ronisillman/FilaBoss/README.md

# FilaBoss
Mechatronics Project Filament Maker
