ronisillman/FilaBoss/PCB/FilaBoss_control_PCB/Print Schematic.pdf

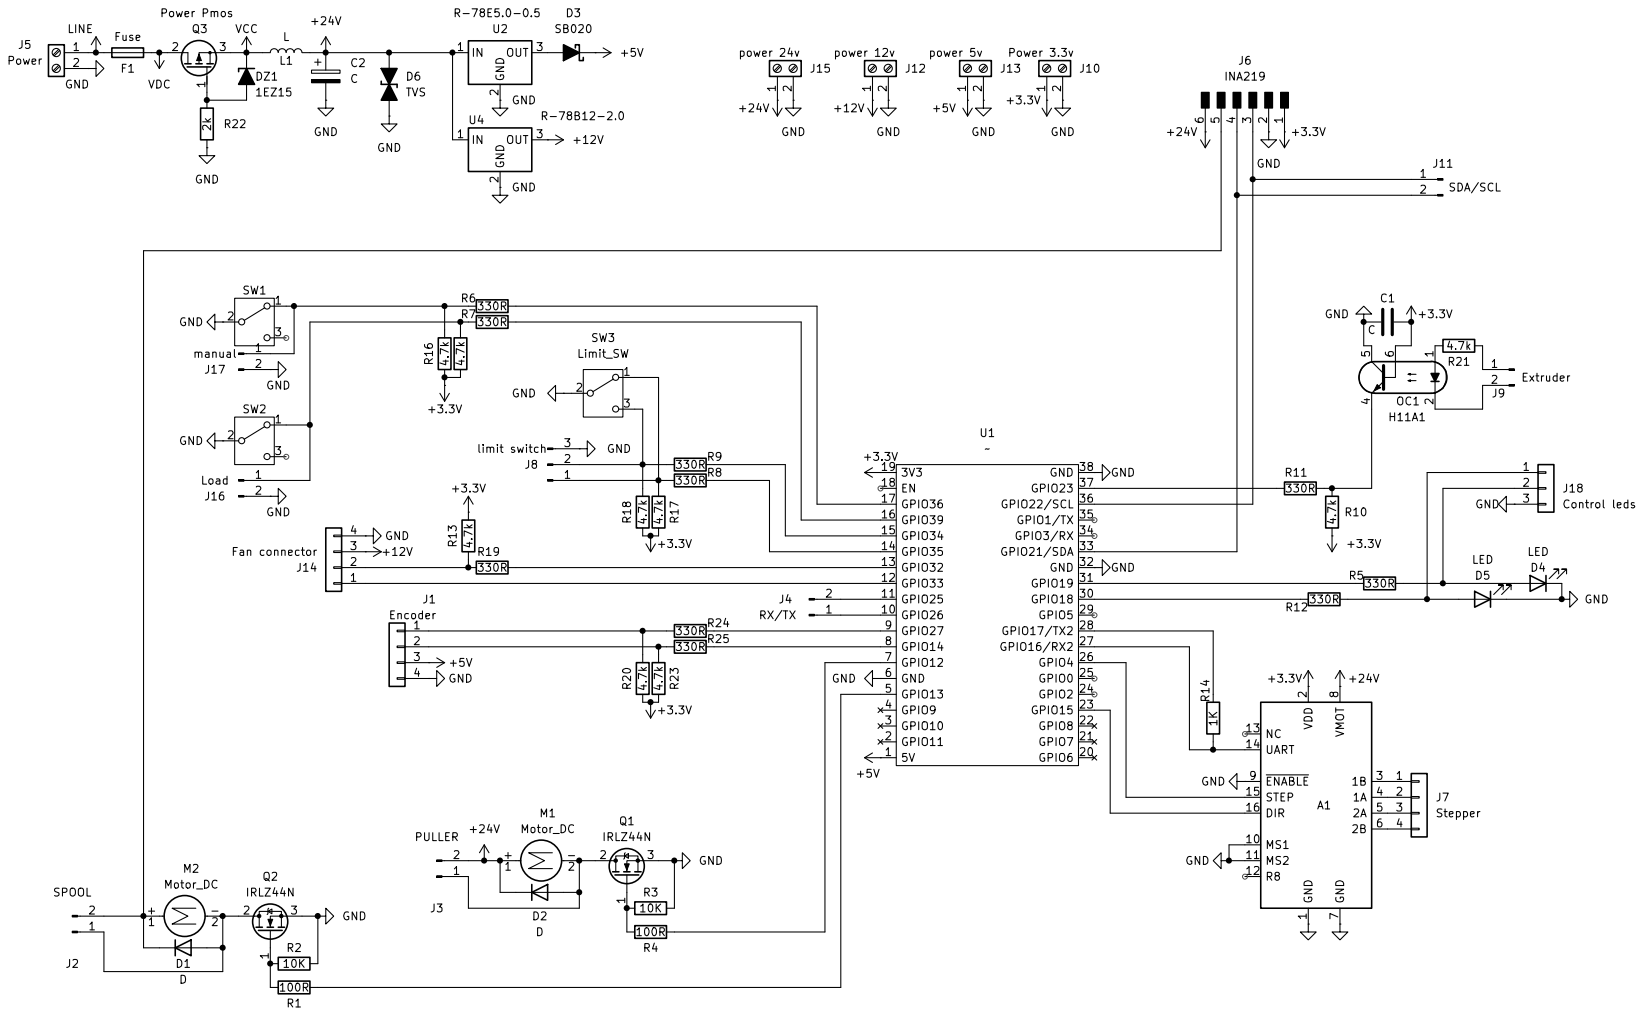
[picture p1: page 1]
