ronisillman/FilaBoss/PCB/FilaBoss_control_PCB/board.pdf

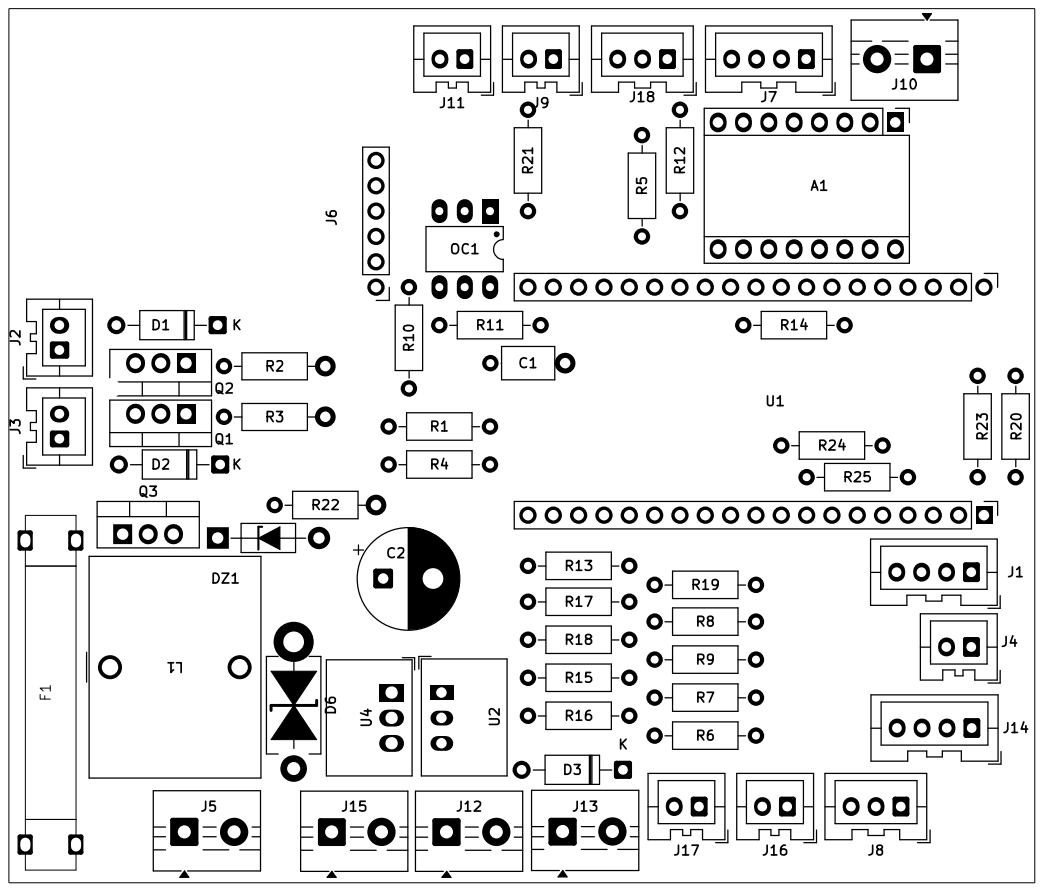
[picture p2: page 1]
