ronisillman/FilaBoss/PCB/FilaBoss_control_PCB/FilaBoss_control_PCB.kicad_pcb

## KiCad design PCB/FilaBoss_control_PCB/FilaBoss_control_PCB.kicad_pcb (2026-04-21)

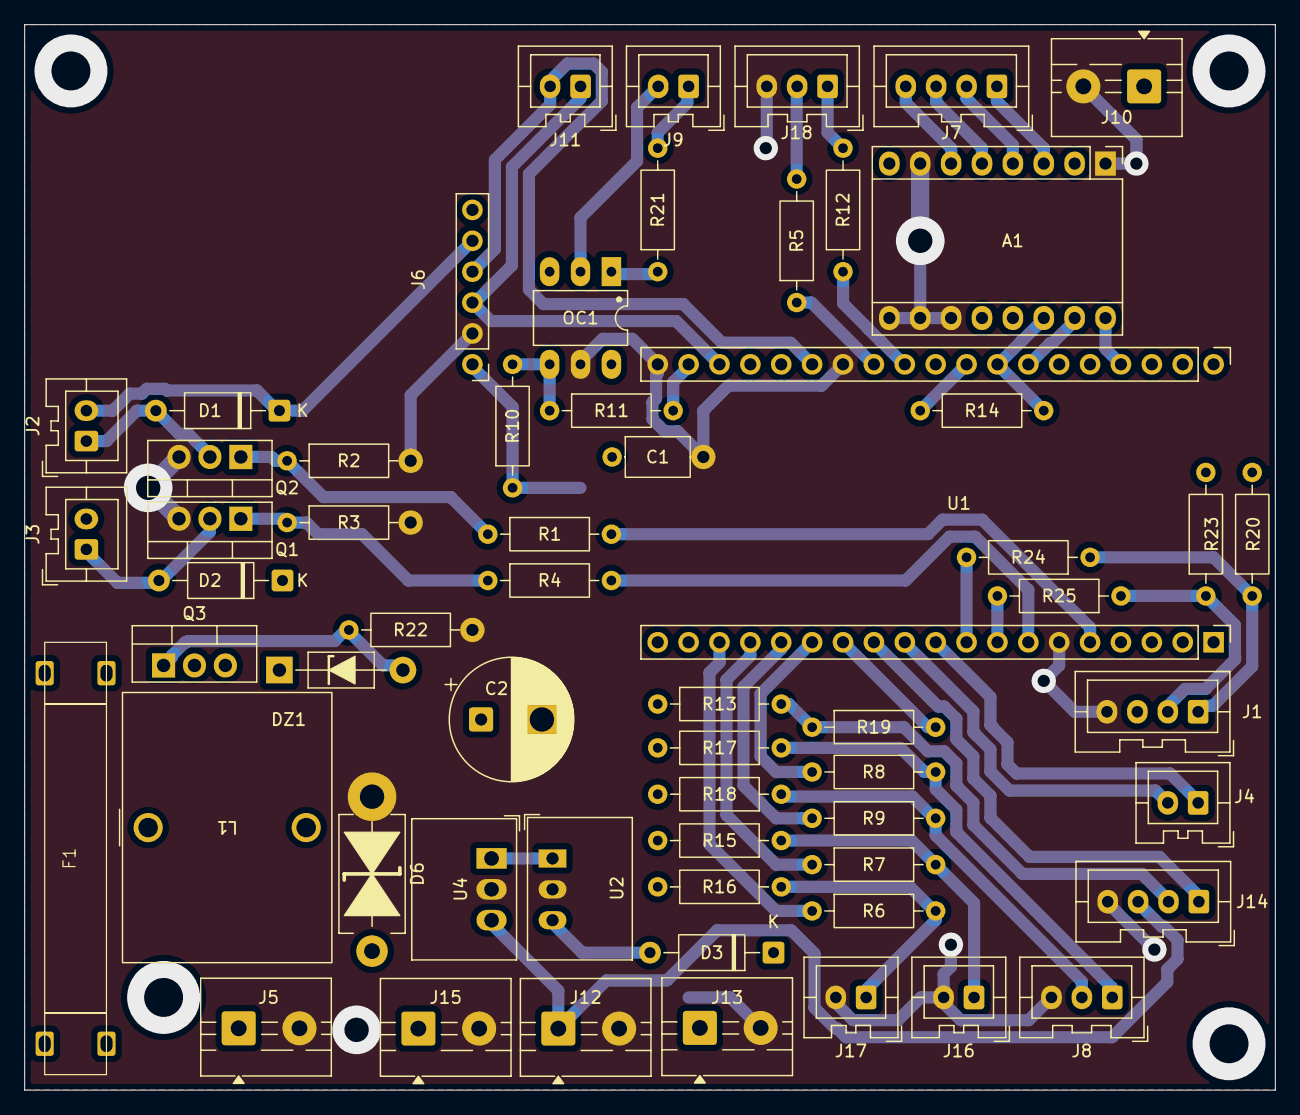
[picture p3: board FilaBoss_control_PCB.kicad_pcb from above]

Board: 2 copper layers, 102.9 x 87.6 mm, 60 parts (0 on the bottom side), 53 nets.

Parts:
A1: Pololu_Breakout_A4988; Pololu_Breakout-16_15.2x20.3mm
C1: C; C_Axial_L5.1mm_D3.1mm_P7.50mm_Horizontal
C2: C; CP_Radial_D10.0mm_P5.00mm
D1, D2: D; D_A-405_P10.16mm_Horizontal
D3: SB020; D_A-405_P10.16mm_Horizontal
D6: TVS; D_DO-201_P12.70mm_Horizontal_TVS
DZ1: 1EZ15; D_DO-41_SOD81_P10.16mm_Horizontal_Zener
F1: Fuse; fuse
J1: Encoder; JST_XA_B04B-XASK-1_1x04_P2.50mm_Vertical
J2: SPOOL; JST_XA_B02B-XASK-1_1x02_P2.50mm_Vertical
J3: PULLER; JST_XA_B02B-XASK-1_1x02_P2.50mm_Vertical
J4: RX/TX; JST_XA_B02B-XASK-1_1x02_P2.50mm_Vertical
J5: Power; TerminalBlock_MaiXu_MX126-5.0-02P_1x02_P5.00mm
J6: INA219; PinHeader_01x06_P2.54mm_Vertical_THT_D1mm
J7: Stepper; JST_XA_B04B-XASK-1_1x04_P2.50mm_Vertical
J8: limit switch; JST_XA_B03B-XASK-1_1x03_P2.50mm_Vertical
J9: Extruder; JST_XA_B02B-XASK-1_1x02_P2.50mm_Vertical
J10: Power 3.3v; TerminalBlock_MaiXu_MX126-5.0-02P_1x02_P5.00mm
J11: SDA/SCL; JST_XA_B02B-XASK-1_1x02_P2.50mm_Vertical
J12: power 12v; TerminalBlock_MaiXu_MX126-5.0-02P_1x02_P5.00mm
J13: power 5v; TerminalBlock_MaiXu_MX126-5.0-02P_1x02_P5.00mm
J14: Fan connector; JST_XA_B04B-XASK-1_1x04_P2.50mm_Vertical
J15: power 24v; TerminalBlock_MaiXu_MX126-5.0-02P_1x02_P5.00mm
J16: Load; JST_XA_B02B-XASK-1_1x02_P2.50mm_Vertical
J17: manual; JST_XA_B02B-XASK-1_1x02_P2.50mm_Vertical
J18: Control leds; JST_XA_B03B-XASK-1_1x03_P2.50mm_Vertical
L1: L; L_Wurth_WE-HCFT-2012_LeadDiameter1.2mm
OC1: H11A1; DIP-6_W7.62mm_LongPads
Q1, Q2: IRLZ44N; TO-220-3_Vertical
Q3: IRF9540N; TO-220-3_Vertical_GDS
R1, R4: 100R; R_Axial_DIN0207_L6.3mm_D2.5mm_P10.16mm_Horizontal
R2, R3: 10K; R_Axial_DIN0207_L6.3mm_D2.5mm_P10.16mm_Horizontal
R5, R6, R7, R8, R9, R11, R12, R19, R24, R25: 330R; R_Axial_DIN0207_L6.3mm_D2.5mm_P10.16mm_Horizontal
R10, R13, R15, R16, R17, R18, R20, R21, R23: 4.7k; R_Axial_DIN0207_L6.3mm_D2.5mm_P10.16mm_Horizontal
R14: 1K; R_Axial_DIN0207_L6.3mm_D2.5mm_P10.16mm_Horizontal
R22: 2k; R_Axial_DIN0207_L6.3mm_D2.5mm_P10.16mm_Horizontal
U1: ESP32 Wroom dev-kit
U2: R-78E5.0-0.5; Converter_DCDC_RECOM_R-78E-0.5_THT
U4: R-78B12-2.0; Converter_DCDC_RECOM_R-78B-2.0_THT

Connections:
+3.3V: A1.2 (VDD), C1.1, J6.1, J10.1, OC1.6, R10.1, R13.1, R15.2, R16.2, R17.2, R18.2, R20.2, R23.2, U1.19 (3V3)
+5V: D3.1 (K), J1.3, J13.1, U1.1 (5V)
+12V: J12.1, J14.3, U4.3 (OUT)
+24V: A1.8 (VMOT), C2.1, D2.1 (K), D6.2 (A), J3.2, J6.6, J15.1, L1.2, U2.1 (IN), U4.1 (IN)
GND: A1.1 (GND), A1.7 (GND), A1.9 (~ENABLE), A1.10 (MS1), A1.11 (MS2), C1.2, C2.2, D6.1 (K), J1.4, J5.2, J6.2, J8.3, J10.2, J12.2, J13.2, J14.4, J15.2, J16.2, J17.2, J18.3, OC1.5, Q1.3 (S), Q2.3 (S), R2.2, R3.2, R22.1, U1.6 (GND), U1.32 (GND), U1.38 (GND), U2.2 (GND), U4.2 (GND)
LINE: F1.1, J5.1
unnamed: A1.4 (1A), J7.2
unnamed: A1.3 (1B), J7.1
unnamed: A1.5 (2A), J7.3
unnamed: A1.6 (2B), J7.4
unnamed: A1.16 (DIR), U1.23 (GPIO15)
unnamed: A1.15 (STEP), U1.26 (GPIO4)
unnamed: A1.14 (UART), R14.2, U1.27 (GPIO16/RX2)
unnamed: D1.2 (A), J2.1, Q2.2 (D)
unnamed: D1.1 (K), J2.2, J6.5
unnamed: D2.2 (A), J3.1, Q1.2 (D)
unnamed: D3.2 (A), U2.3 (OUT)
unnamed: DZ1.2 (A), Q3.1 (G), R22.2
unnamed: J1.1, R20.1, R24.1
unnamed: J1.2, R23.1, R25.1
unnamed: J4.1, U1.10 (GPIO26)
unnamed: J4.2, U1.11 (GPIO25)
unnamed: J8.1, R8.1, R17.1
unnamed: J8.2, R9.1, R18.1
unnamed: J9.1, R21.2
unnamed: J9.2, OC1.2
unnamed: J6.3, J11.1, U1.36 (GPIO22/SCL)
unnamed: J6.4, J11.2, U1.33 (GPIO21/SDA)
unnamed: J14.1, U1.12 (GPIO33)
unnamed: J14.2, R13.2, R19.1
unnamed: J16.1, R7.2, R15.1
unnamed: J17.1, R6.2, R16.1
unnamed: J18.1, R12.2
unnamed: J18.2, R5.2
unnamed: OC1.1, R21.1
unnamed: OC1.4, R10.2, R11.1
unnamed: Q1.1 (G), R3.1, R4.1
unnamed: Q2.1 (G), R1.1, R2.1
unnamed: R4.2, U1.7 (GPIO12)
unnamed: R1.2, U1.5 (GPIO13)
unnamed: R25.2, U1.8 (GPIO14)
unnamed: R14.1, U1.28 (GPIO17/TX2)
unnamed: R12.1, U1.30 (GPIO18)
unnamed: R5.1, U1.31 (GPIO19)
unnamed: R11.2, U1.37 (GPIO23)
unnamed: R24.2, U1.9 (GPIO27)
unnamed: R19.2, U1.13 (GPIO32)
unnamed: R9.2, U1.15 (GPIO34)
unnamed: R8.2, U1.14 (GPIO35)
unnamed: R6.1, U1.17 (GPIO36)
unnamed: R7.1, U1.16 (GPIO39)
VCC: DZ1.1 (K), L1.1, Q3.3 (S)
VDC: F1.2, Q3.2 (D)
