ronisillman/FilaBoss/PCB/FilaBoss_control_PCB/FilaBoss_control_PCB_s.kicad_pcb

## KiCad design PCB/FilaBoss_control_PCB/FilaBoss_control_PCB_s.kicad_pcb (2026-03-24)

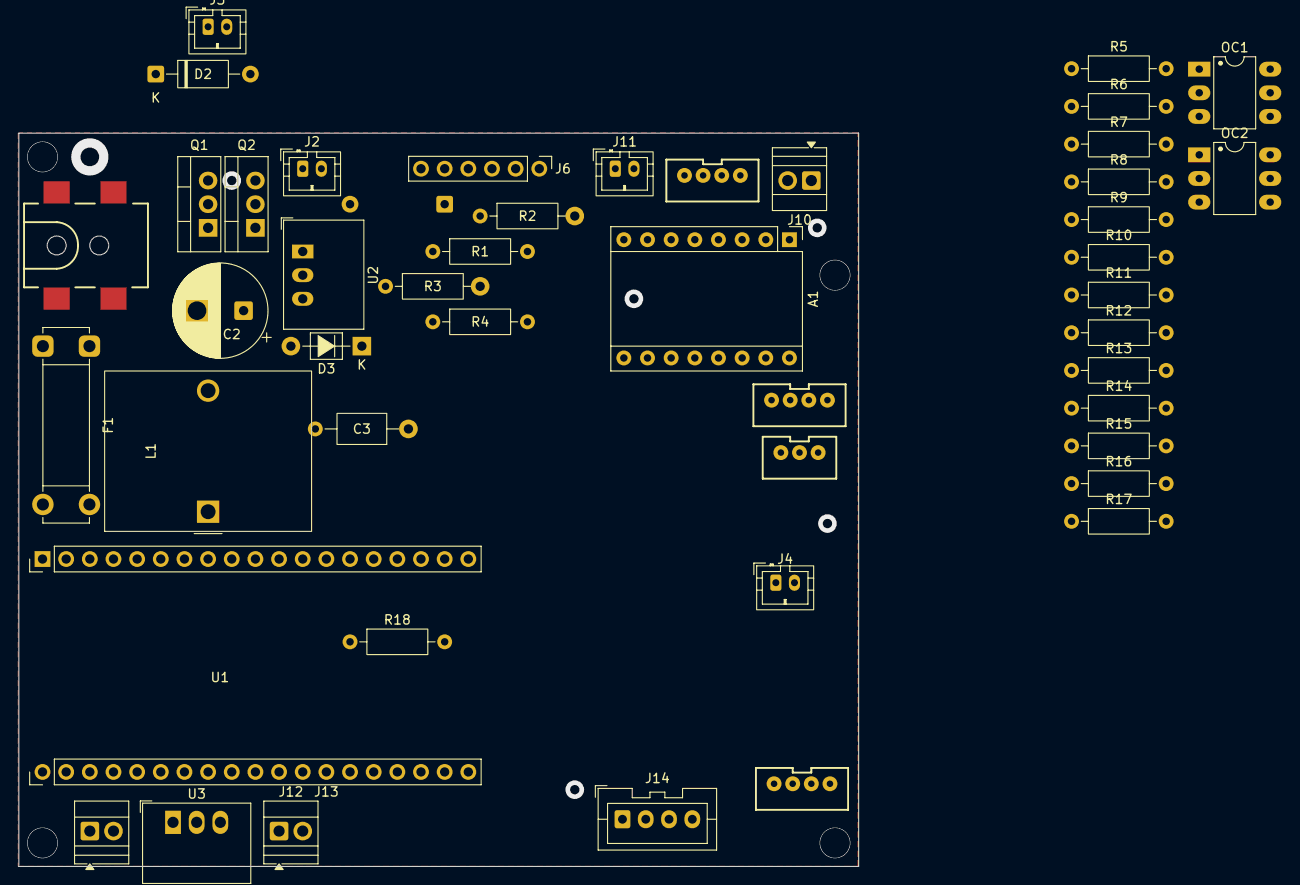
[picture p4: board FilaBoss_control_PCB_s.kicad_pcb from above]

Board: 2 copper layers, 90.2 x 78.7 mm, 47 parts (1 on the bottom side), 45 nets, no tracks yet.

Parts:
A1: Pololu_Breakout_A4988; Pololu_Breakout-16_15.2x20.3mm
C2: C; CP_Radial_D10.0mm_P5.00mm
C3: C; C_Axial_L5.1mm_D3.1mm_P10.00mm_Horizontal
D1, D2: D; D_A-405_P10.16mm_Horizontal
D3: SB020; D_T-1_P7.62mm_Horizontal
F1: Fuse; Fuseholder_Clip-5x20mm_Littelfuse_521_Lateral_P17.00x5.00mm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
J1: Encoder; JST_1x04_P2.0mm_Vertical_PTH
J2: SPOOL; JST_PH_B2B-PH-K_1x02_P2.00mm_Vertical
J3: PULLER; JST_PH_B2B-PH-K_1x02_P2.00mm_Vertical
J4: RX/TX; JST_PH_B2B-PH-K_1x02_P2.00mm_Vertical
J5: Barrel_Jack_SMD
J6: INA219; PinHeader_01x06_P2.54mm_Vertical_THT_D1mm
J7: Stepper; JST_1x04_P2.0mm_Vertical_PTH
J8: limit switch; JST_1x03_P2.0mm_Vertical_PTH
J9: Conn_01x04_Pot; JST_1x04_P2.0mm_Vertical_PTH
J10: Power 3.3v; TerminalBlock_Xinya_XY308-2.54-2P_1x02_P2.54mm_Horizontal
J11: SCL/SDA; JST_PH_B2B-PH-K_1x02_P2.00mm_Vertical
J12: power 12v; TerminalBlock_Xinya_XY308-2.54-2P_1x02_P2.54mm_Horizontal
J13: power 5v; TerminalBlock_Xinya_XY308-2.54-2P_1x02_P2.54mm_Horizontal
J14: Fan connector; JST_XA_B04B-XASK-1_1x04_P2.50mm_Vertical
L1: L; L_Wurth_WE-HCFT-2012_LeadDiameter1.2mm
OC1, OC2: H11A1; DIP-6_W7.62mm_LongPads
Q1, Q2: IRLZ44N; TO-220-3_Vertical
R1, R4, R5, R6, R7, R8, R9: 100R; R_Axial_DIN0207_L6.3mm_D2.5mm_P10.16mm_Horizontal
R2, R3: 10K; R_Axial_DIN0207_L6.3mm_D2.5mm_P10.16mm_Horizontal
R10, R11: 330R; R_Axial_DIN0207_L6.3mm_D2.5mm_P10.16mm_Horizontal
R12, R13, R14, R15, R16, R17, R18: 4.7k; R_Axial_DIN0207_L6.3mm_D2.5mm_P10.16mm_Horizontal
U1: ESP32 Wroom dev-kit
U2: R-78E5.0-0.5; Converter_DCDC_RECOM_R-78E-0.5_THT
U3: R-78B12-2.0; Converter_DCDC_RECOM_R-78B-2.0_THT

Connections:
+3.3V: A1.2 (VDD), A1.10 (MS1), A1.11 (MS2), A1.12 (MS3), A1.13 (~RESET), A1.14 (~SLEEP), J6.1, J10.2, R12.2, R13.2, R14.2, R15.2, R16.2, R17.2, R18.2, U1.19 (3V3)
+5V: C3.2, D3.1 (K), J1.2, J13.1, R10.2, R11.2, U1.1 (5V)
+12V: J12.1, J14.2, U3.3 (OUT)
+24V: A1.8 (VMOT), C2.1, D2.1 (K), J3.2 (+), J6.6, L1.2, U2.1 (IN), U3.1 (IN)
GND: A1.1 (GND), A1.7 (GND), A1.9 (~ENABLE), C2.2, C3.1, J1.1, J5.GND, J6.2, J8.3, J9.1, J10.1, J12.2, J13.2, J14.1, OC1.5, OC2.5, Q1.3 (S), Q2.3 (S), R2.2, R3.2, U1.6 (GND), U1.32 (GND), U1.38 (GND), U2.2 (GND), U3.2 (GND)
LINE: F1.1, J5.PWR
unnamed: A1.4 (1A), J7.2
unnamed: A1.3 (1B), J7.1
unnamed: A1.5 (2A), J7.3
unnamed: A1.6 (2B), J7.4
unnamed: A1.16 (DIR), U1.13 (GPIO32)
unnamed: A1.15 (STEP), U1.12 (GPIO33)
unnamed: D1.2 (A), J2.1 (-), Q2.2 (D)
unnamed: D1.1 (K), J2.2 (+), J6.5
unnamed: D2.2 (A), J3.1 (-), Q1.2 (D)
unnamed: D3.2 (A), U2.3 (OUT)
unnamed: J1.3, OC2.2
unnamed: J1.4, OC1.2
unnamed: J4.2 (+), U1.28 (GPIO17/TX2)
unnamed: J4.1 (-), U1.27 (GPIO16/RX2)
unnamed: J8.1, R9.1, R18.1
unnamed: J8.2, R8.1, R17.1
unnamed: J9.2, R5.2, R14.1
unnamed: J9.3, R7.2, R15.1
unnamed: J9.4, R6.2, R16.1
unnamed: J6.4, J11.2 (+), U1.33 (GPIO21/SDA)
unnamed: J6.3, J11.1 (-), U1.36 (GPIO22/SCL)
unnamed: J14.3, U1.25 (GPIO0)
unnamed: J14.4, U1.24 (GPIO2)
unnamed: OC1.1, R10.1
unnamed: OC1.6, R12.1
unnamed: OC2.1, R11.1
unnamed: OC2.6, R13.1
unnamed: Q1.1 (G), R3.1, R4.1
unnamed: Q2.1 (G), R1.1, R2.1
unnamed: R5.1, U1.29 (GPIO5)
unnamed: R9.2, U1.7 (GPIO12)
unnamed: R8.2, U1.5 (GPIO13)
unnamed: OC1.4, U1.8 (GPIO14)
unnamed: R7.1, U1.30 (GPIO18)
unnamed: R6.1, U1.31 (GPIO19)
unnamed: R1.2, U1.11 (GPIO25)
unnamed: R4.2, U1.10 (GPIO26)
unnamed: OC2.4, U1.9 (GPIO27)
VDC: F1.2, L1.1
