ronisillman/FilaBoss/PCB/FilaBoss_control_PCB/FilaBoss_control_PCB_b.kicad_pcb

## KiCad design PCB/FilaBoss_control_PCB/FilaBoss_control_PCB_b.kicad_pcb (2026-03-13)

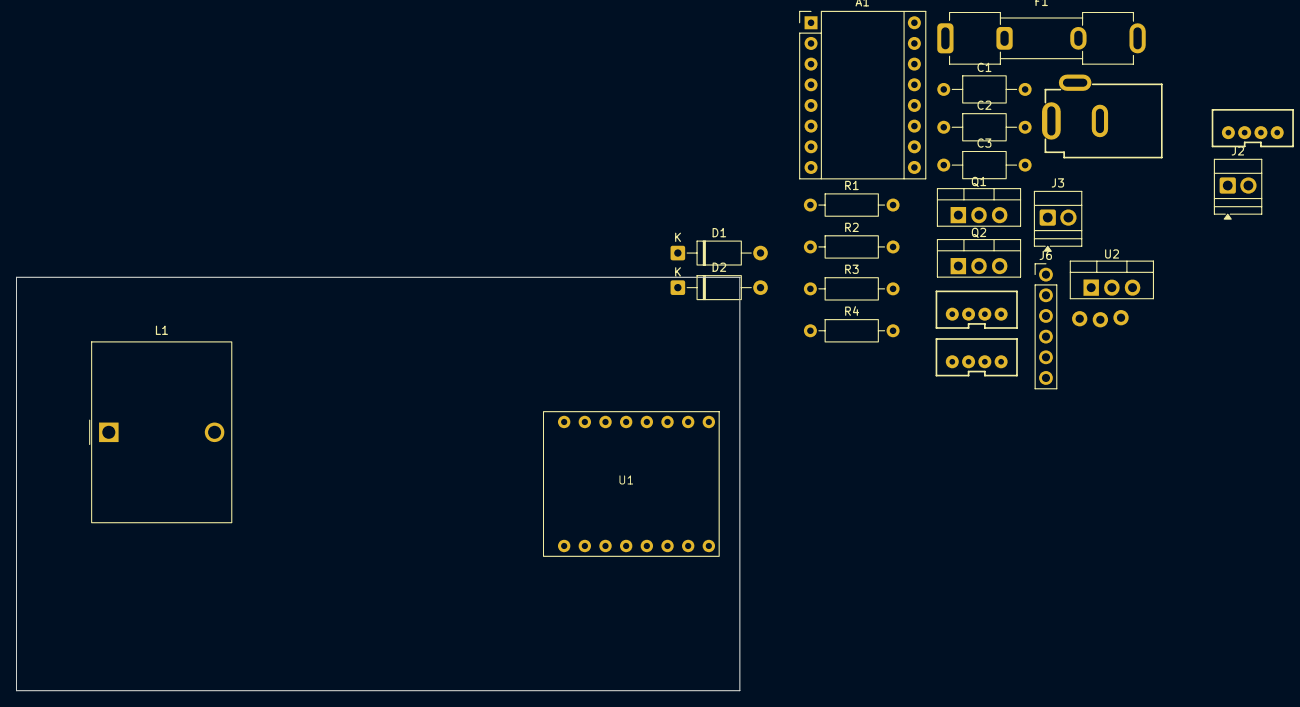
[picture p5: board FilaBoss_control_PCB_b.kicad_pcb from above]

Board: 2 copper layers, 88.9 x 50.8 mm, 24 parts (0 on the bottom side), 29 nets, no tracks yet.

Parts:
A1: Pololu_Breakout_A4988; Pololu_Breakout-16_15.2x20.3mm
C1, C2, C3: C; C_Axial_L5.1mm_D3.1mm_P10.00mm_Horizontal
D1, D2: D; D_A-405_P10.16mm_Horizontal
F1: Fuse; Fuseholder_Clip-5x20mm_Keystone_3512P_Inline_P23.62x7.27mm_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
J1, J9: Conn_01x04_Encoder; JST_1x04_P2.0mm_Vertical_PTH
J2, J3: Screw_Terminal_01x02; TerminalBlock_Xinya_XY308-2.54-2P_1x02_P2.54mm_Horizontal
J5: Barrel_Jack_PTH_Slot
J6: PinHeader_01x06_P2.54mm_Vertical_THT_D1mm
J7: Conn_01x04; JST_1x04_P2.0mm_Vertical_PTH
J8: Conn_01x03; 1x03_P2.54mm_Locking
L1: L; L_Wurth_WE-HCFT-2012_LeadDiameter1.2mm
Q1, Q2: IRLZ44N; TO-220-3_Vertical
R1, R4: 100R; R_Axial_DIN0207_L6.3mm_D2.5mm_P10.16mm_Horizontal
R2, R3: 10K; R_Axial_DIN0207_L6.3mm_D2.5mm_P10.16mm_Horizontal
U1: ESP32_C3_super_mini; ESP32-super-mini
U2: LM78M05_TO220; TO-220-3_Vertical

Connections:
+24V: F1.1, J5.PWR
GND: A1.1 (GND), A1.7 (GND), A1.9 (~ENABLE), C1.2, C2.2, C3.2, J1.4, J5.GND, J6.2, J8.3, J9.1, Q1.3 (S), Q2.3 (S), R2.2, R3.2, U1.12 (GND), U2.2 (GND)
unnamed: A1.4 (1A), J7.2
unnamed: A1.3 (1B), J7.1
unnamed: A1.5 (2A), J7.3
unnamed: A1.6 (2B), J7.4
unnamed: A1.16 (DIR), U1.20 (D7/RX)
unnamed: A1.2 (VDD), A1.10 (MS1), A1.11 (MS2), A1.12 (MS3), J1.3, J6.1, U1.11 (3V3)
unnamed: A1.15 (STEP), U1.21 (D6/TX)
unnamed: A1.8 (VMOT), C2.1, D1.1 (K), D2.1 (K), J2.1, J3.1, L1.2, U2.1 (VI)
unnamed: A1.13 (~RESET), A1.14 (~SLEEP)
unnamed: D1.2 (A), J2.2, J6.6
unnamed: D2.2 (A), J3.2, Q1.2 (D)
unnamed: F1.2, L1.1
unnamed: J1.1, U1.4 (D2/A2)
unnamed: J1.2, U1.3 (D1/A1)
unnamed: J6.3, U1.7 (D5/SCL)
unnamed: J6.4, U1.6 (D4/SDA)
unnamed: J6.5, Q2.2 (D)
unnamed: J8.1, U1.1 (ADC1-1)
unnamed: J8.2, U1.0 (ADC1-0)
unnamed: J9.2, U1.10 (D10/MOSI)
unnamed: J9.3, U1.9 (D9/MISO)
unnamed: J9.4, U1.8 (D8/SCK)
unnamed: Q1.1 (G), R3.1, R4.1
unnamed: Q2.1 (G), R1.1, R2.1
unnamed: C1.1, C3.1, U1.13 (5V), U2.3 (VO)
unnamed: R4.2, U1.2 (D0/A0)
unnamed: R1.2, U1.5 (D3/A3)
