ronisillman/FilaBoss/Arduino code/Control/Winding_line_control_esp/pid.h

// PID Controller Class for Arduino

class PID {
private:
  float kp, ki, kd;
  float setpoint;
  float integral;
  float previousError;
  unsigned long lastTime;
  float outputMin, outputMax, output;
  float derivativeFilterCoeff;  // Filter coefficient for derivative smoothing (0.1-1.0)
  float previousFilteredDerivative;  // Previous filtered derivative value

public:
  // Constructor
  PID(float kp_val = 0.0, float ki_val = 0.0, float kd_val = 0.0) {
    kp = kp_val;
    ki = ki_val;
    kd = kd_val;
    setpoint = 0.0;
    integral = 0.0;
    previousError = 0.0;
    lastTime = micros();
    outputMin = -255.0;
    outputMax = 255.0;
    output = 0.0;
    derivativeFilterCoeff = 0.2;  // Default filter coefficient (lower = more smoothing)
    previousFilteredDerivative = 0.0;
  }

  // Set PID tuning parameters
  void setTunings(float kp_val, float ki_val, float kd_val) {
    kp = kp_val;
    ki = ki_val;
    kd = kd_val;
    previousFilteredDerivative = 0.0; // Reset filter state: old state was scaled by previous kd
  }

  // Get PID tuning parameters
  float getKp() { return kp; }
  float getKi() { return ki; }
  float getKd() { return kd; }

  // Set derivative filter coefficient (0.0-1.0, lower = more smoothing)
  void setDerivativeFilter(float filterCoeff) {
    derivativeFilterCoeff = constrain(filterCoeff, 0.01, 1.0);
  }

  // Set the desired setpoint
  void setSetpoint(float target) {
    setpoint = target;
  }

  // Set output limits
  void setOutputLimits(float minOut, float maxOut) {
    outputMin = minOut;
    outputMax = maxOut;
  }

  float compute(float feedback, float feedforwardInput = 0.0f) {
    unsigned long currentTime = micros();
    float deltaTime = (currentTime - lastTime) / 1000000.0; // Convert to seconds

    // Avoid division by zero - return previous output if no time has passed
    if (deltaTime == 0) return output;
    
    lastTime = currentTime;

    // Calculate error
    float error = setpoint - feedback;

    // Proportional term
    float proportional = kp * error;

    // Derivative term with filtering
    float rawDerivative = kd * (error - previousError) / deltaTime;
    float derivative = previousFilteredDerivative + derivativeFilterCoeff * (rawDerivative - previousFilteredDerivative);
    previousFilteredDerivative = derivative;

    // Integral term with anti-windup: only update if the new output would not drive further into saturation
    float deltaIntegral = ki * error * deltaTime;
    float prospectiveIntegral = integral + deltaIntegral;
    float prospectiveOutput = proportional + prospectiveIntegral + derivative + feedforwardInput;
    if (!((prospectiveOutput > outputMax && deltaIntegral > 0.0f) ||
          (prospectiveOutput < outputMin && deltaIntegral < 0.0f))) {
      integral = prospectiveIntegral;
    }

    // Store error for next iteration
    previousError = error;

    // Calculate output with feedforward
    output = proportional + integral + derivative + feedforwardInput;

    // Limit output
    output = constrain(output, outputMin, outputMax);
    return output;
  }

  // Reset the controller
  void reset() {
    integral = 0.0;
    previousError = 0.0;
    previousFilteredDerivative = 0.0;
    lastTime = micros();
  }

  // Get current setpoint
  float getSetpoint() {
    return setpoint;
  }

  // Get current integral value
  float getIntegral() {
    return integral;
  }

  // Get current output value
  float getOutput() {
    return output;
  }

  // Get current output limits
  float getOutputMax() {
    return outputMax;
  }
  float getOutputMin() {
    return outputMin;
  }

  // Get derivative filter coefficient
  float getDerivativeFilter() {
    return derivativeFilterCoeff;
  }
};
