ronisillman/FilaBoss/Arduino code/DC_motor_encoder_pulses/DC_motor_encoder_pulses.ino

#define encoderPin 2

volatile long pulseCount = 0;
volatile bool lastState = LOW;

void setup() {
  pinMode(encoderPin, INPUT);
  Serial.begin(9600);

  attachInterrupt(digitalPinToInterrupt(encoderPin), countPulse, CHANGE);
}

void loop() {
  static unsigned long lastTime = 0;
  if (millis() - lastTime >= 1000) {
    noInterrupts();
    long pulses = pulseCount;
    pulseCount = 0;
    interrupts();

    Serial.print("Pulses in last 1 s: ");
    Serial.println(pulses);
    lastTime = millis();
  }
}

void countPulse() {
  static unsigned long lastBounceTime = 0;
  unsigned long now = micros();  // micros() for better debounce resolution
  
  // Debounce with 1000µs (1ms) threshold
  if (now - lastBounceTime > 1000) {
    bool state = digitalRead(encoderPin);
    if (state == HIGH && lastState == LOW) {
      pulseCount++;
    }
    lastState = state;
    lastBounceTime = now;
  }
}
