ronisillman/FilaBoss/python_lcd_ui/main.py

from __future__ import annotations

# pyright: reportMissingImports=false

import argparse
import csv
import importlib
import json
import math
import os
import socket
import time
from dataclasses import asdict, dataclass
from typing import Any

from display_hardware import HardwareLcdDisplay
from display_simulator import SimulatedLcdDisplay
from input_devices import InputEvent, RotaryButtonInput
from ui_controller import UiController


DEFAULT_UNIX_SOCKET_PATH = os.path.join(
    os.path.dirname(os.path.abspath(__file__)),
    "sockets",
    "filament_socket.sock",
)
UI_STATE_PATH = os.path.join(
    os.path.dirname(os.path.abspath(__file__)),
    "ui_state.json",
)


@dataclass
class TelemetryFromEsp32:
    load_mode: bool
    waiting_for_load: bool
    filament_speed_mps: float
    fan_rpm: float
    diameter_travelled_mm: float
    spool_current_ma: float

    @classmethod
    def from_json_line(cls, line: str) -> TelemetryFromEsp32:
        data = json.loads(line)
        if not isinstance(data, dict):
            raise ValueError("Telemetry JSON must be an object")

        return cls(
            load_mode=bool(data.get("load_mode", False)),
            waiting_for_load=bool(data.get("waiting_for_load", False)),
            filament_speed_mps=float(data.get("filament_speed_mps", 0.0)),
            fan_rpm=float(data.get("fan_rpm", 0.0)),
            diameter_travelled_mm=float(data.get("diameter_travelled_mm", 0.0)),
            spool_current_ma=float(data.get("spool_current_ma", 0.0)),
        )

    def apply_to_controller(self, controller: UiController) -> None:
        state = controller.state
        state.load_mode = self.load_mode
        state.waiting_for_load = self.waiting_for_load
        # ESP sends m/s, UI displays mm/s.
        state.pulley_speed_mps = self.filament_speed_mps * 1000.0
        state.fan_rpm = self.fan_rpm
        state.diameter_travelled_mm = self.diameter_travelled_mm
        state.spool_current_ma = self.spool_current_ma
        state.esp_last_received = time.monotonic()


@dataclass
class DiameterFromVision:
    timestamp: str | None
    top_mm: float
    middle_mm: float
    bottom_mm: float
    roundness: float | None

    @classmethod
    def from_json_line(cls, line: str) -> DiameterFromVision:
        data = json.loads(line)
        if not isinstance(data, dict):
            raise ValueError("Diameter JSON must be an object")

        def parse_optional_float(value: Any) -> float | None:
            if value is None:
                return None
            try:
                return float(value)
            except (TypeError, ValueError):
                return None

        def parse_optional_timestamp(value: Any) -> str | None:
            if value is None:
                return None
            text = str(value).strip()
            return text if text else None

        return cls(
            timestamp=parse_optional_timestamp(data.get("timestamp")),
            top_mm=float(data["top_mm"]),
            middle_mm=float(data["middle_mm"]),
            bottom_mm=float(data["bottom_mm"]),
            roundness=parse_optional_float(data.get("roundness")),
        )

    def apply_to_controller(self, controller: UiController) -> None:
        mean_diameter_mm = (self.top_mm + self.middle_mm + self.bottom_mm) / 3.0
        if math.isfinite(mean_diameter_mm):
            controller.state.filament_diameter_mm = round(mean_diameter_mm, 3)
        controller.state.vision_last_received = time.monotonic()


@dataclass
class CommandsToEsp32:
    pid_p_pulley_dia: float
    pid_i_pulley_dia: float
    pid_d_pulley_dia: float
    pid_p_pulley_spd: float
    pid_i_pulley_spd: float
    pid_d_pulley_spd: float
    pid_p_spool: float
    pid_i_spool: float
    pid_d_spool: float
    fan_speed_pct: int
    spool_current_target_ma: float
    target_mode: str
    target_diameter_mm: float
    measured_diameter_mm: float
    target_speed_mps: float

    @classmethod
    def from_controller(cls, controller: UiController) -> CommandsToEsp32:
        state = controller.state

        def finite_or_default(value: float, default: float) -> float:
            return float(value) if math.isfinite(value) else float(default)

        return cls(
            pid_p_pulley_dia=state.pulley_dia_gains.p.to_float(),
            pid_i_pulley_dia=state.pulley_dia_gains.i.to_float(),
            pid_d_pulley_dia=state.pulley_dia_gains.d.to_float(),
            pid_p_pulley_spd=state.pulley_spd_gains.p.to_float(),
            pid_i_pulley_spd=state.pulley_spd_gains.i.to_float(),
            pid_d_pulley_spd=state.pulley_spd_gains.d.to_float(),
            pid_p_spool=state.spool_gains.p.to_float(),
            pid_i_spool=state.spool_gains.i.to_float(),
            pid_d_spool=state.spool_gains.d.to_float(),
            fan_speed_pct=state.fan_speed_pct,
            spool_current_target_ma=finite_or_default(state.spool_current_target_ma, 50.0),
            target_mode=state.target_mode,
            target_diameter_mm=finite_or_default(state.target_diameter_hundredths / 100.0, 1.75),
            measured_diameter_mm=finite_or_default(state.filament_diameter_mm, 1.75),
            # UI target is in mm/s with one decimal (e.g. 00.1), convert to m/s for ESP.
            target_speed_mps=finite_or_default(state.target_speed_tenths / 10000.0, 0.01),
        )

    def to_json_line(self) -> str:
        payload: dict[str, Any] = {
            "p1": self.pid_p_pulley_dia,
            "i1": self.pid_i_pulley_dia,
            "d1": self.pid_d_pulley_dia,
            "p2": self.pid_p_pulley_spd,
            "i2": self.pid_i_pulley_spd,
            "d2": self.pid_d_pulley_spd,
            "p3": self.pid_p_spool,
            "i3": self.pid_i_spool,
            "d3": self.pid_d_spool,
            "f": self.fan_speed_pct,
            "c": self.spool_current_target_ma,
            "m": self.target_mode,
            "td": self.target_diameter_mm,
            "md": self.measured_diameter_mm,
            "ts": self.target_speed_mps,
        }
        return json.dumps(payload, separators=(",", ":"), allow_nan=False) + "\n"


def load_ui_state(controller: UiController, file_path: str) -> None:
    try:
        with open(file_path, "r", encoding="utf-8") as handle:
            data = json.load(handle)
    except (OSError, ValueError, TypeError):
        return

    state = controller.state

    def set_int(name: str, minimum: int, maximum: int) -> None:
        value = data.get(name)
        if isinstance(value, int):
            setattr(state, name, max(minimum, min(maximum, value)))

    def set_float(name: str, minimum: float, maximum: float) -> None:
        value = data.get(name)
        if isinstance(value, (int, float)) and math.isfinite(float(value)):
            setattr(state, name, max(minimum, min(maximum, float(value))))

    if isinstance(data.get("target_mode"), str) and data["target_mode"] in {"Dia", "Spd"}:
        state.target_mode = data["target_mode"]

    set_int("target_diameter_hundredths", 0, 999)
    set_int("target_speed_tenths", 0, 999)
    set_int("fan_speed_pct", 0, 100)
    set_float("spool_current_target_ma", 0.0, 995.0)

    def load_gain_setting(gain_setting: "GainSetting", data_dict: object) -> None:
        if not isinstance(data_dict, dict):
            return
        digits = data_dict.get("digits")
        dot_index = data_dict.get("dot_index")
        if isinstance(digits, int) and 0 <= digits <= 99999:
            gain_setting.digits = digits
        if isinstance(dot_index, int) and 0 <= dot_index <= 5:
            gain_setting.dot_index = dot_index

    def load_pid_gains(pid_gains: "PidGains", key: str) -> None:
        gains_data = data.get(key)
        if not isinstance(gains_data, dict):
            return
        load_gain_setting(pid_gains.p, gains_data.get("p"))
        load_gain_setting(pid_gains.i, gains_data.get("i"))
        load_gain_setting(pid_gains.d, gains_data.get("d"))

    load_pid_gains(state.pulley_dia_gains, "pulley_dia_gains")
    load_pid_gains(state.pulley_spd_gains, "pulley_spd_gains")
    load_pid_gains(state.spool_gains, "spool_gains")

    if isinstance(data.get("pid_motor_index"), int):
        state.pid_motor_index = max(0, min(2, data["pid_motor_index"]))


def save_ui_state(controller: UiController, file_path: str) -> None:
    state = controller.state
    payload = {
        "target_mode": state.target_mode,
        "target_diameter_hundredths": state.target_diameter_hundredths,
        "target_speed_tenths": state.target_speed_tenths,
        "fan_speed_pct": state.fan_speed_pct,
        "spool_current_target_ma": state.spool_current_target_ma,
        "pid_motor_index": state.pid_motor_index,
        "pulley_dia_gains": {
            "p": asdict(state.pulley_dia_gains.p),
            "i": asdict(state.pulley_dia_gains.i),
            "d": asdict(state.pulley_dia_gains.d),
        },
        "pulley_spd_gains": {
            "p": asdict(state.pulley_spd_gains.p),
            "i": asdict(state.pulley_spd_gains.i),
            "d": asdict(state.pulley_spd_gains.d),
        },
        "spool_gains": {
            "p": asdict(state.spool_gains.p),
            "i": asdict(state.spool_gains.i),
            "d": asdict(state.spool_gains.d),
        },
    }

    tmp_path = f"{file_path}.tmp"
    try:
        with open(tmp_path, "w", encoding="utf-8") as handle:
            json.dump(payload, handle, separators=(",", ":"))
        os.replace(tmp_path, file_path)
    except OSError:
        try:
            if os.path.exists(tmp_path):
                os.remove(tmp_path)
        except OSError:
            pass


class SerialJsonBridge:
    """Newline-delimited JSON bridge for ESP32 communication."""

    def __init__(self, port: str, baudrate: int, timeout: float = 0.0) -> None:
        try:
            serial = importlib.import_module("serial")
        except ImportError as exc:
            raise RuntimeError("pyserial is required for serial communication. Run: pip install pyserial") from exc

        self._serial_module = serial
        self._port = port
        self._baudrate = baudrate
        self._timeout = timeout
        self._serial = self._open_serial()
        self._rx_buffer = ""
        self._next_reconnect_time = 0.0

    def _open_serial(self) -> Any:
        return self._serial_module.Serial(
            port=self._port,
            baudrate=self._baudrate,
            timeout=self._timeout,
        )

    def _mark_disconnected(self) -> None:
        if self._serial is not None:
            try:
                self._serial.close()
            except Exception:
                pass
        self._serial = None
        self._rx_buffer = ""
        self._next_reconnect_time = time.monotonic() + 1.0

    def _ensure_connected(self) -> bool:
        if self._serial is not None:
            return True

        now = time.monotonic()
        if now < self._next_reconnect_time:
            return False

        try:
            self._serial = self._open_serial()
            self._next_reconnect_time = 0.0
            return True
        except Exception:
            self._next_reconnect_time = now + 1.0
            return False

    def read_line(self) -> str | None:
        if not self._ensure_connected():
            return None

        # Always consume already-buffered complete lines first.
        if "\n" in self._rx_buffer:
            line, self._rx_buffer = self._rx_buffer.split("\n", 1)
            return line.strip()

        assert self._serial is not None

        try:
            waiting = int(self._serial.in_waiting)
        except Exception:
            self._mark_disconnected()
            return None

        if waiting <= 0:
            return None

        try:
            chunk = self._serial.read(waiting).decode("utf-8", errors="replace")
        except Exception:
            self._mark_disconnected()
            return None

        if not chunk:
            return None

        self._rx_buffer += chunk
        if "\n" not in self._rx_buffer:
            return None

        line, self._rx_buffer = self._rx_buffer.split("\n", 1)
        return line.strip()

    def write_line(self, line: str) -> None:
        if not self._ensure_connected():
            return

        assert self._serial is not None

        try:
            self._serial.write(line.encode("utf-8"))
        except Exception:
            self._mark_disconnected()

    def close(self) -> None:
        if self._serial is not None:
            self._serial.close()


class UnixJsonBridge:
    """Newline-delimited JSON bridge over a local Unix domain socket."""

    def __init__(self, socket_path: str) -> None:
        if not hasattr(socket, "AF_UNIX"):
            raise RuntimeError("Unix domain sockets are not supported on this platform")

        self._socket_path = socket_path
        self._server = socket.socket(socket.AF_UNIX, socket.SOCK_STREAM)
        self._client: socket.socket | None = None
        self._rx_buffer = ""

        if os.path.exists(self._socket_path):
            os.remove(self._socket_path)

        self._server.bind(self._socket_path)
        self._server.listen(1)
        self._server.setblocking(False)

    def _accept_client_if_needed(self) -> None:
        if self._client is not None:
            return

        try:
            conn, _ = self._server.accept()
        except BlockingIOError:
            return

        conn.setblocking(False)
        self._client = conn

    def _drop_client(self) -> None:
        if self._client is not None:
            self._client.close()
            self._client = None
        self._rx_buffer = ""

    def read_line(self) -> str | None:
        if "\n" in self._rx_buffer:
            line, self._rx_buffer = self._rx_buffer.split("\n", 1)
            return line.strip()

        self._accept_client_if_needed()
        if self._client is None:
            return None

        try:
            chunk = self._client.recv(4096)
        except BlockingIOError:
            return None
        except OSError:
            self._drop_client()
            return None

        if not chunk:
            self._drop_client()
            return None

        self._rx_buffer += chunk.decode("utf-8", errors="replace")
        if "\n" not in self._rx_buffer:
            return None

        line, self._rx_buffer = self._rx_buffer.split("\n", 1)
        return line.strip()

    def close(self) -> None:
        self._drop_client()
        self._server.close()
        if os.path.exists(self._socket_path):
            os.remove(self._socket_path)


class CsvMeasurementLogger:
    """Append diameter measurements to CSV from the UI runtime."""

    def __init__(self, file_path: str) -> None:
        self._file = open(file_path, "w", newline="")
        self._writer = csv.writer(self._file)
        self._writer.writerow([
            "Timestamp",
            "Distance_mm",
            "Top_mm",
            "Middle_mm",
            "Bottom_mm",
            "Roundness",
        ])
        self._file.flush()

    def write_row(self, timestamp: str, distance_mm: float, top_mm: float, middle_mm: float, bottom_mm: float, roundness: float | None) -> None:
        self._writer.writerow([
            timestamp,
            round(distance_mm, 3),
            round(top_mm, 3),
            round(middle_mm, 3),
            round(bottom_mm, 3),
            "" if roundness is None else round(roundness, 3),
        ])
        self._file.flush()

    def close(self) -> None:
        self._file.close()


def session_csv_log_path(base_path: str, started_at: float) -> str:
    directory = os.path.dirname(base_path)
    filename = os.path.basename(base_path)
    stem, ext = os.path.splitext(filename)
    if not ext:
        ext = ".csv"
    if not stem:
        stem = "filament_log"

    if directory:
        os.makedirs(directory, exist_ok=True)

    ts = time.strftime("%Y%m%d_%H%M%S", time.localtime(started_at))
    return os.path.join(directory, f"{stem}_{ts}{ext}") if directory else f"{stem}_{ts}{ext}"


def default_csv_log_path() -> str:
    reports_dir = "/home/filaboss/Filament reports"
    os.makedirs(reports_dir, exist_ok=True)
    return os.path.join(reports_dir, "filament_log.csv")


def parse_args() -> argparse.Namespace:
    parser = argparse.ArgumentParser(
        description="FilaBoss LCD UI (simulator and Raspberry Pi hardware modes)"
    )
    parser.add_argument("--mode", choices=["sim", "hw"], default="sim")
    parser.add_argument("--cols", type=int, default=20)
    parser.add_argument("--rows", type=int, default=4)

    parser.add_argument("--i2c-address", type=lambda x: int(x, 0), default=0x27)
    parser.add_argument("--i2c-port", type=int, default=1)

    parser.add_argument("--pin-clk", type=int, default=17)
    parser.add_argument("--pin-dt", type=int, default=27)
    parser.add_argument("--pin-sw", type=int, default=22)

    parser.add_argument("--serial-port", type=str, default="/dev/ttyUSB0")
    parser.add_argument("--serial-baudrate", type=int, default=115200)
    parser.add_argument("--serial-tx-hz", type=float, default=20.0)
    parser.add_argument("--unix-socket-path", type=str, default=DEFAULT_UNIX_SOCKET_PATH)
    parser.add_argument("--csv-log-path", type=str, default=default_csv_log_path())
    parser.add_argument("--csv-log-interval", type=float, default=5.0)

    parser.add_argument("--fps", type=float, default=12.0)
    parser.add_argument("--monitor", action="store_true", help="Show live target/state monitor below the simulated LCD (sim mode only)")
    return parser.parse_args()


def main() -> None:
    args = parse_args()
    controller = UiController(cols=args.cols, rows=args.rows)
    load_ui_state(controller, UI_STATE_PATH)

    display = None
    input_device = None
    serial_bridge: SerialJsonBridge | None = None
    unix_bridge: UnixJsonBridge | None = None
    csv_logger: CsvMeasurementLogger | None = None

    try:
        if args.mode == "sim":
            display = SimulatedLcdDisplay(cols=args.cols, rows=args.rows, monitor=args.monitor)
        else:
            display = HardwareLcdDisplay(
                cols=args.cols,
                rows=args.rows,
                i2c_address=args.i2c_address,
                i2c_port=args.i2c_port,
            )
            input_device = RotaryButtonInput(
                pin_clk=args.pin_clk,
                pin_dt=args.pin_dt,
                pin_sw=args.pin_sw,
            )
            if args.serial_port:
                serial_bridge = SerialJsonBridge(
                    port=args.serial_port,
                    baudrate=args.serial_baudrate,
                    timeout=0.0,
                )
                # Show startup prompt until ESP reports normal operation.
                controller.state.waiting_for_load = True

        if args.mode == "hw" and args.unix_socket_path:
            unix_bridge = UnixJsonBridge(args.unix_socket_path)
            controller.state.waiting_for_load = False

        frame_delay = 1.0 / max(1.0, args.fps)
        tx_period = 1.0 / max(1.0, args.serial_tx_hz)
        next_tx_time = time.monotonic()
        telemetry_apply_period = 1.0
        next_telemetry_apply_time = time.monotonic()
        csv_log_interval = max(0.1, float(args.csv_log_interval))
        next_csv_log_time = time.monotonic()
        pending_esp_telemetry: TelemetryFromEsp32 | None = None
        pending_diameter: DiameterFromVision | None = None
        last_diameter_for_csv: DiameterFromVision | None = None
        last_load_mode = controller.state.load_mode
        next_state_save_time = time.monotonic()
        running = True

        while running:
            events: list[InputEvent] = []
            if args.mode == "sim":
                display.refresh_ui()
                if not display.is_open:
                    break
                events = display.poll_events()
            elif input_device is not None:
                events = input_device.poll_events()

            if args.mode == "hw" and serial_bridge is not None:
                while True:
                    telemetry_line = serial_bridge.read_line()
                    if telemetry_line is None:
                        break

                    try:
                        pending_esp_telemetry = TelemetryFromEsp32.from_json_line(telemetry_line)
                    except (ValueError, json.JSONDecodeError):
                        # Ignore malformed telemetry lines and keep last valid state.
                        pass

            if unix_bridge is not None:
                while True:
                    telemetry_line = unix_bridge.read_line()
                    if telemetry_line is None:
                        break

                    try:
                        pending_diameter = DiameterFromVision.from_json_line(telemetry_line)
                        last_diameter_for_csv = pending_diameter
                    except (ValueError, json.JSONDecodeError):
                        # Ignore malformed telemetry lines and keep last valid state.
                        pass

            now = time.monotonic()
            if now >= next_telemetry_apply_time:
                if pending_esp_telemetry is not None:
                    pending_esp_telemetry.apply_to_controller(controller)
                    pending_esp_telemetry = None
                if pending_diameter is not None:
                    pending_diameter.apply_to_controller(controller)
                    pending_diameter = None
                next_telemetry_apply_time = now + telemetry_apply_period

            for event in events:
                if not controller.handle_event(event):
                    running = False
                    break

            # Load mode transition handling for CSV sessions.
            load_mode = controller.state.load_mode
            if last_load_mode and not load_mode:
                if args.csv_log_path:
                    try:
                        session_path = session_csv_log_path(args.csv_log_path, time.time())
                        csv_logger = CsvMeasurementLogger(session_path)
                        next_csv_log_time = time.monotonic() + csv_log_interval
                    except Exception:
                        csv_logger = None
            elif (not last_load_mode) and load_mode:
                if csv_logger is not None:
                    try:
                        csv_logger.close()
                    except Exception:
                        pass
                    csv_logger = None

            last_load_mode = load_mode

            now = time.monotonic()
            if now >= next_csv_log_time and csv_logger is not None and last_diameter_for_csv is not None:
                csv_timestamp = last_diameter_for_csv.timestamp
                if csv_timestamp is None:
                    csv_timestamp = time.strftime("%Y-%m-%d %H:%M:%S")

                try:
                    csv_logger.write_row(
                        timestamp=csv_timestamp,
                        distance_mm=controller.state.diameter_travelled_mm,
                        top_mm=last_diameter_for_csv.top_mm,
                        middle_mm=last_diameter_for_csv.middle_mm,
                        bottom_mm=last_diameter_for_csv.bottom_mm,
                        roundness=last_diameter_for_csv.roundness,
                    )
                except Exception:
                    csv_logger = None
                next_csv_log_time = now + csv_log_interval

            use_simulated_feedback = (args.mode == "sim" and serial_bridge is None and unix_bridge is None) # change this if needed *****
            controller.tick(simulate_feedback=use_simulated_feedback)

            if args.mode == "hw" and serial_bridge is not None:
                now = time.monotonic()
                if now >= next_tx_time:
                    commands_json = CommandsToEsp32.from_controller(controller).to_json_line()
                    serial_bridge.write_line(commands_json)
                    next_tx_time = now + tx_period

            now = time.monotonic()
            if now >= next_state_save_time:
                save_ui_state(controller, UI_STATE_PATH)
                next_state_save_time = now + 1.0

            lines = controller.render_lines()
            for row, text in enumerate(lines):
                display.write_line(row, text)

            if args.mode == "sim" and args.monitor and hasattr(display, "update_monitor"):
                s = controller.state
                cmd = CommandsToEsp32.from_controller(controller)
                monitor_text = (
                    f"Mode: {s.target_mode}   "
                    f"Target Dia: {s.target_diameter_hundredths / 100.0:.2f} mm   "
                    f"Target Spd: {s.target_speed_tenths / 10.0:.1f} mm/s\n"
                    f"Fan: {s.fan_speed_pct}%   "
                    f"Spool Current Target: {s.spool_current_target_ma:.0f} mA\n"
                    f"PID Pulley/Dia  P:{s.pulley_dia_gains.p.to_float():.4g}  I:{s.pulley_dia_gains.i.to_float():.4g}  D:{s.pulley_dia_gains.d.to_float():.4g}   "
                    f"PID Pulley/Spd  P:{s.pulley_spd_gains.p.to_float():.4g}  I:{s.pulley_spd_gains.i.to_float():.4g}  D:{s.pulley_spd_gains.d.to_float():.4g}   "
                    f"PID Spool  P:{s.spool_gains.p.to_float():.4g}  I:{s.spool_gains.i.to_float():.4g}  D:{s.spool_gains.d.to_float():.4g}\n"
                )
                display.update_monitor(monitor_text)

            time.sleep(frame_delay)

    except KeyboardInterrupt:
        pass
    finally:
        if csv_logger is not None:
            csv_logger.close()
        if unix_bridge is not None:
            unix_bridge.close()
        if serial_bridge is not None:
            serial_bridge.close()
        if input_device is not None:
            input_device.close()
        if display is not None:
            display.close()


if __name__ == "__main__":
    main()
