ronisillman/FilaBoss/(commit log)

2026-02-02 arduino code init
2026-02-03 current measurement code init
2026-02-03 measuring two current sensors code
2026-02-03 DC motor control code init
2026-02-03 combining dc motor and current measurement in one code
2026-02-06 Filament guide test file
2026-02-06 Non blocking stepper control(untested)
2026-02-06 Combined arduino control file
2026-02-06 added encoder code that counts pulses per second
2026-02-08 +pid class
2026-02-08 parallel calibration and homing of the guide stepper
2026-02-09 Ready for testing(configure pin setup and test values)
2026-02-09 encoder implementation and bug fix
    [Winding_line_control.ino]
2026-02-09 encoder code, deleted motor lines
2026-02-09 fixed encoder code
2026-02-09 fixed low pid gain, added filter constants, diagnose function, speed decay
    [Winding_line_control.ino]
2026-02-18 new code for 600 pulses encoder
2026-02-18 pot controls for both speed and current targets, PID gain for speed and current
2026-02-23 new 24 VDC motors and removal of other current sensor
2026-02-24 corrected pid gains for 24V roller motor
    [Winding_line_control.ino]
2026-02-24 digital pot. function. NEED more interrupt pins
2026-02-24 prep for board switch
2026-03-02 added stand alone magnetometer measurement code
2026-03-02 added stand alone magnetometer and encoder measurement code
2026-03-04 stepper test
2026-03-04 magnetometer_test update
2026-03-04 added magnetometer measurement to main code
2026-03-10 diagnose stepper
2026-03-10 stepper trouble shooting+ interrupt limit switching
2026-03-10 Optimization, bugfix, stepper diagnostic
    [Winding_line_control.ino]
2026-03-11 stepper functional
2026-03-13 pcb v1 ready
    [FilaBoss_control_PCB.kicad_pcb, FilaBoss_control_PCB.kicad_sch, FilaBoss_control_PCB_b.kicad_pcb]
2026-03-15 forgot custom lib
    [FilaBoss_control_PCB.kicad_pcb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]
2026-03-16 bigger esp required
    [FilaBoss_control_PCB.kicad_pcb, FilaBoss_control_PCB.kicad_sch]
2026-03-16 stepper motor test codes
2026-03-17 pcb converted to esp32 wroom
    [FilaBoss_control_PCB.kicad_pcb, FilaBoss_control_PCB.kicad_sch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]
2026-03-20 moved everything unnecessary out of interrupt codes
2026-03-24 interrupt -> pcnt, and speed calibration code
2026-03-24 external pullups to encoder
2026-03-25 pcb v2
    [FilaBoss_control_PCB.kicad_pcb, FilaBoss_control_PCB.kicad_sch]
2026-03-26 pcb documentation
    [FilaBoss_control_PCB.kicad_pcb, FilaBoss_control_PCB.kicad_sch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]
2026-03-28 added speed calibration
2026-03-28 serial input for speed and current
2026-03-28 fan control and rpm measurement
2026-03-28 load mode and stepper library
2026-03-28 fixed stepper dir
2026-03-29 tmc uart connection
2026-03-29 load phase: changed to stepper driver
2026-03-31 tmc2209v2 pcb updates
    [FilaBoss_control_PCB.kicad_pcb, FilaBoss_control_PCB.kicad_sch]
2026-04-01 pcb WIP
    [FilaBoss_control_PCB.kicad_sch]
2026-04-01 clean up and modifications to load and stepper control
2026-04-01 fixed "#include <Wire.h>" error
2026-04-02 pcb v3
    [FilaBoss_control_PCB.kicad_pcb, FilaBoss_control_PCB.kicad_sch]
2026-04-02 stepper calibrations
2026-04-02 after reset wait for load mode, added manual mode
    [Winding_line_control_esp.ino]
2026-04-03 correct fan rpm measurement and fixed extruder srew and manual switch logic
    [Winding_line_control_esp.ino]
2026-04-03 updated code, only one error situation remains: after reset if control paused is released only after load mode
    [Winding_line_control_esp.ino]
2026-04-03 fixed distance reset after load mode
    [Winding_line_control_esp.ino]
2026-04-06 blinking motor selection
2026-04-06 test print to ui
2026-04-06 ui encoder test
2026-04-06 reverset encoder directions
2026-04-06 pcb v4
    [FilaBoss_control_PCB.kicad_pcb, FilaBoss_control_PCB.kicad_sch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]
2026-04-06 fixed fan speed padding on ui
    [ui_controller.py]
2026-04-06 communication init to esp32 and raspberry main.py
2026-04-07 esp32 -> rasberry test codes
2026-04-07 ui shows actual values from esp32
2026-04-07 included the missing current control from ui
    [Winding_line_control_esp.ino, main.py, ui_controller.py]
2026-04-07 faster ui encoder readings
2026-04-07 correct spool current readings to ui
    [main.py, ui_controller.py]
2026-04-07 more fixes to current ui
    [main.py, ui_controller.py]
2026-04-07 correct telemetry reading on ui
    [main.py]
2026-04-07 lower stepper run current
2026-04-07 added wait screen to ui with esp reset
    [Winding_line_control_esp.ino, main.py, ui_controller.py]
2026-04-07 increased guide run current
2026-04-08 communication socket edits
2026-04-08 socket changes
2026-04-08 right socket dir
2026-04-08 socket faster update rate
2026-04-08 ui seperate pulley gains to esp32
2026-04-08 no unix socket with sim mode ui
2026-04-15 changed "FAN" to "CONTROL"
2026-04-15 fixed exiting load mode
    [Winding_line_control_esp.ino, main.py]
2026-04-15 saving ui values to config file, and fixed serial comminucation
    [Winding_line_control_esp.ino, main.py]
2026-04-15 fixed load mode exiting guide bugs
    [Winding_line_control_esp.ino]
2026-04-15 camera calibrations
2026-04-15 negative pulley diameter gains
2026-04-15 fixed ui pid target values
    [display_simulator.py, main.py, ui_controller.py]
2026-04-16 better camera calibration codes
2026-04-16 changed calibration screen sizes
2026-04-16 removed threshold harcoding from scale calibration
2026-04-16 added missing numpy definition
    [camerafocus.py]
2026-04-16 launch script for calibration
2026-04-16 better calibration codes
2026-04-22 cast to int bug fix, pcnt overflow check for speed, lower alpha for speed.
    [Winding_line_control_esp.ino]
2026-04-22 Cascade dia pid control
2026-04-22 Millis to micros
2026-04-22 Derivative filtering
2026-04-22 diameter pid changes
2026-04-22 pid derivate changes
2026-04-22 deleted old homing and calibration function
2026-04-22 pid autotune
2026-04-22 comment out json error
    [Winding_line_control_esp.ino]
2026-04-23 feedforward for pid
2026-04-27 Implemented optional feedforward to pid class
2026-04-27 PID inti with zero gains to find errors
    [Winding_line_control_esp.ino]
2026-05-05 Pid windup change
2026-05-05 Clarity, readablilty, corrected leadscrew pitch and roller radius
    [Winding_line_control_esp.ino]
2026-05-05 Default microstep correct = 8
    [Winding_line_control_esp.ino]
